dagdmfc1946/Project---Meteorological-Station-C1B-/Evidencias - Diego García/Archivos de fabricación PCB/Vista 2D Superior.jpg

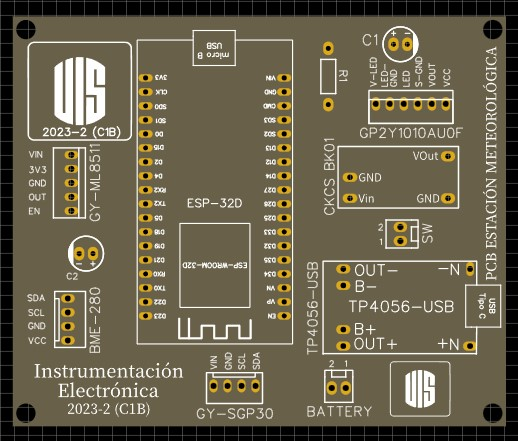
Evidencias - Diego García/Archivos de fabricación PCB/Vista 2D Superior.jpg
