dagdmfc1946/Project---Meteorological-Station-C1B-/README.md

# Proyecto-Estación-Meteorológica-C1B-(2023-1)
Parte del contenido del desarrolo del proyecto de la asignatura "Instrumentación Electrónica" de la carrera de Ingeniería Electrónica de la UIS en el semestre 2023-1.
