dagdmfc1946/Project---Meteorological-Station-C1B-/Evidencias - Diego García/Evidencia_Informe_Instru.pdf

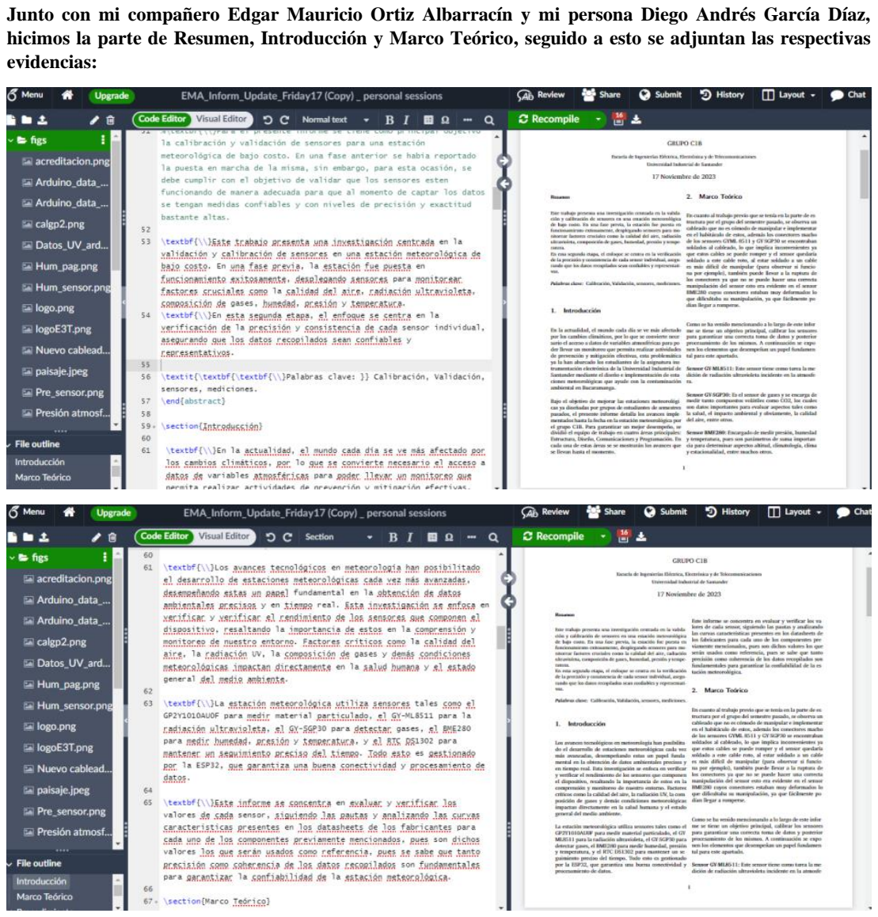
[picture p17: page 1]

Junto con mi compañero Edgar Mauricio Ortiz Albarracín y mi persona Diego Andrés García Díaz, hicimos la parte de Resumen, Introducción y Marco Teórico, seguido a esto se adjuntan las respectivas evidencias:

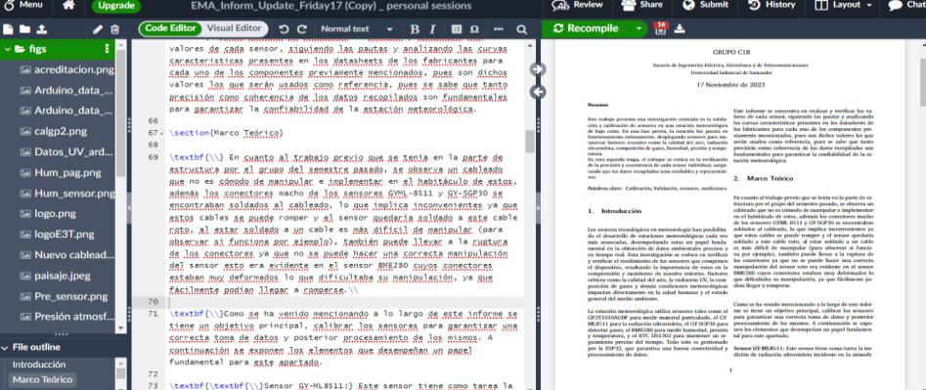
[picture p18: figure]
