dagdmfc1946/Project---Meteorological-Station-C1B-/Evidencias - Diego García/Esquemático y PCB Layout v2.1/Schematic_C1B_v2.1.pdf

# Potencia Sensores

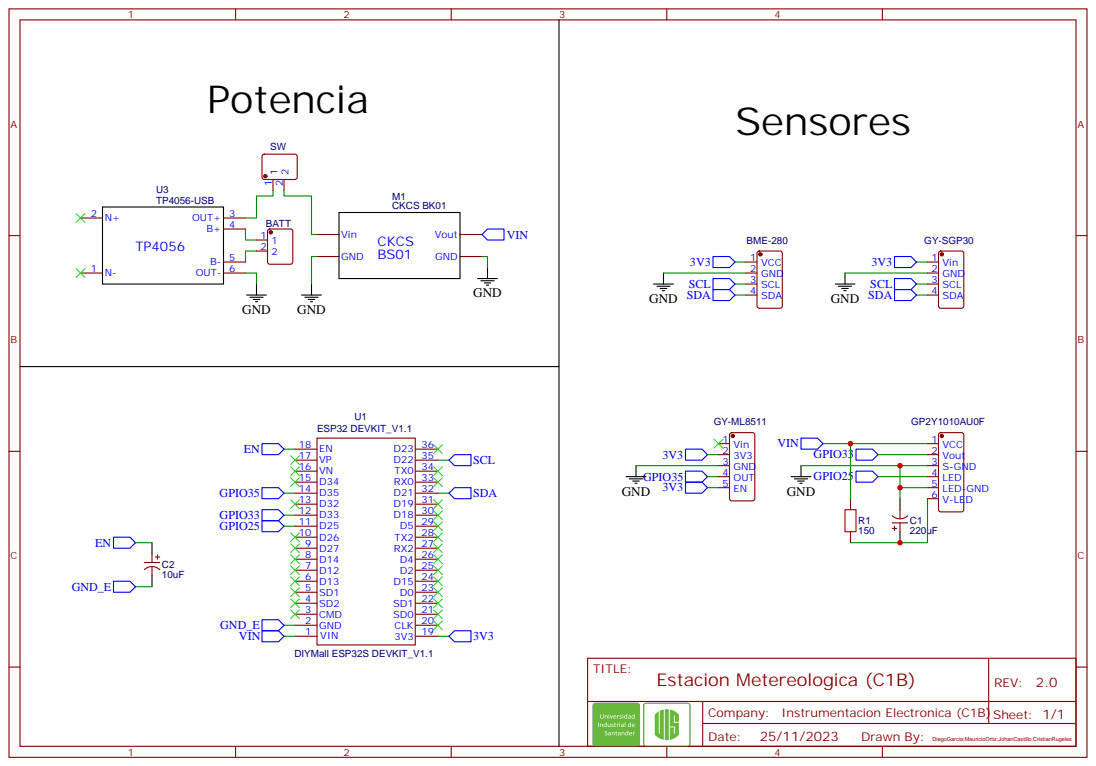
[picture p63: page 1]

Drawn By: DiegoGarcia;MauricioOrtiz;JohanCastillo;CristianRugeles
