dagdmfc1946/Project---Meteorological-Station-C1B-/Evidencias - Diego García/Archivos de fabricación PCB/capa inferior.pdf

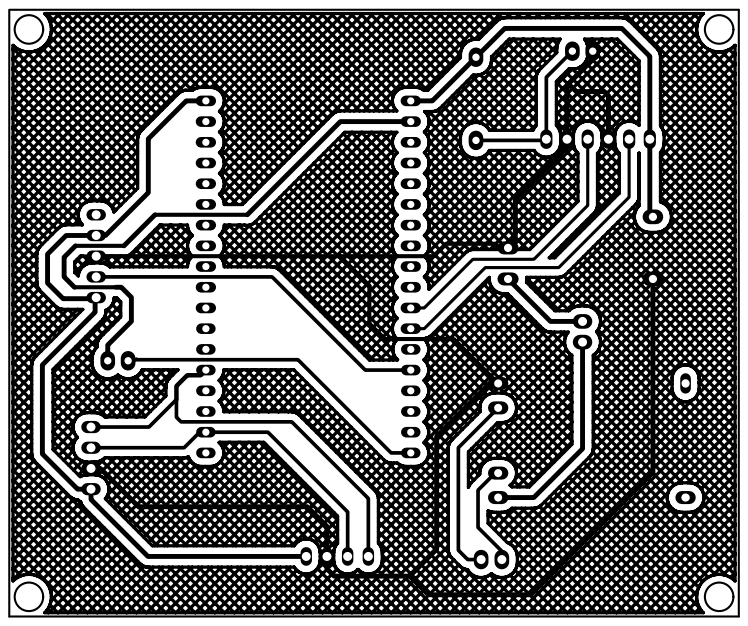
[picture p64: page 1]
