dagdmfc1946/Project---Meteorological-Station-C1B-/Evidencias - Diego García/Archivos de fabricación PCB/nombres superior.pdf

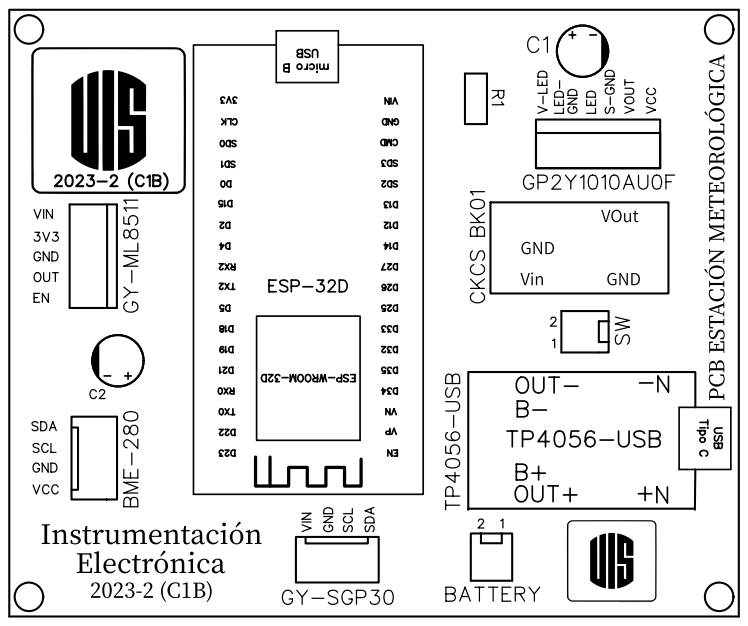
[picture p65: page 1]
