dagdmfc1946/Project---Meteorological-Station-C1B-/Evidencias - Diego García/Archivos de fabricación PCB/pads vista superior.pdf

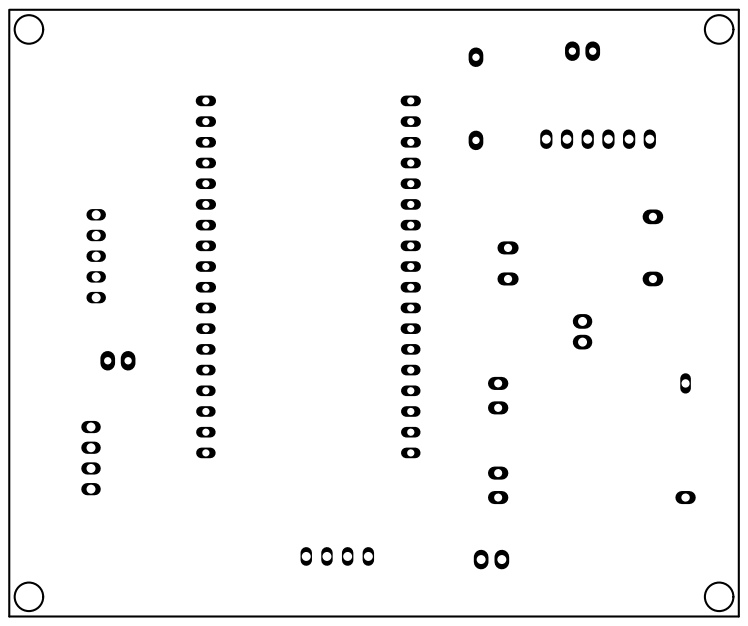
[picture p66: page 1]
