dagdmfc1946/Project---Meteorological-Station-C1B-/Evidencias - Diego García/Esquemático y PCB Layout v2.1/PCB_C1B_v2.1_.pdf

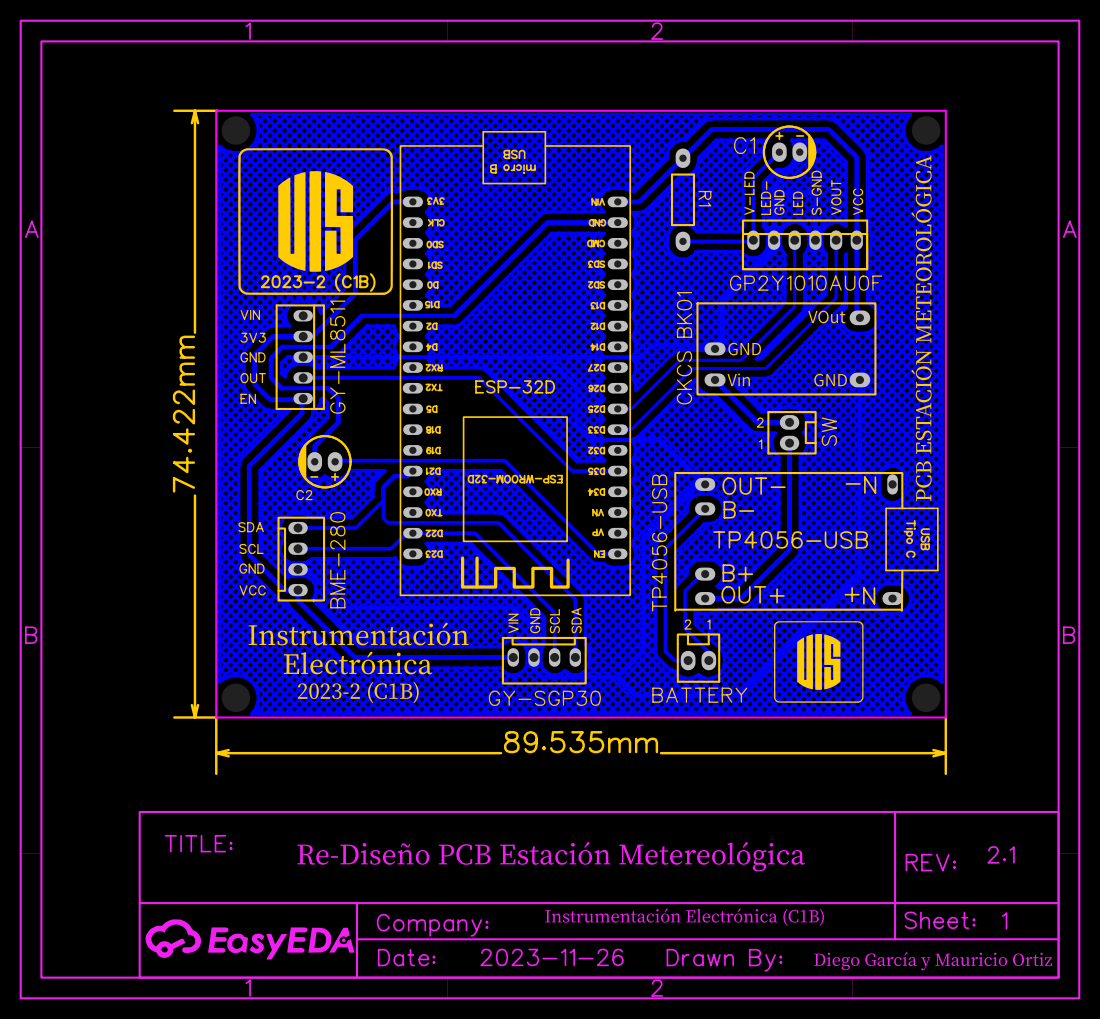
[picture p67: page 1]
